kloper/thermo/README.md

# Thermo

Thermo is a work in progress project aiming to create an electronic thermometer
based on STM32F030 chip.

Follow me on http://kloper.blogspot.com for more info.
