kloper/thermo/doc/stm32f030-basic.PNG

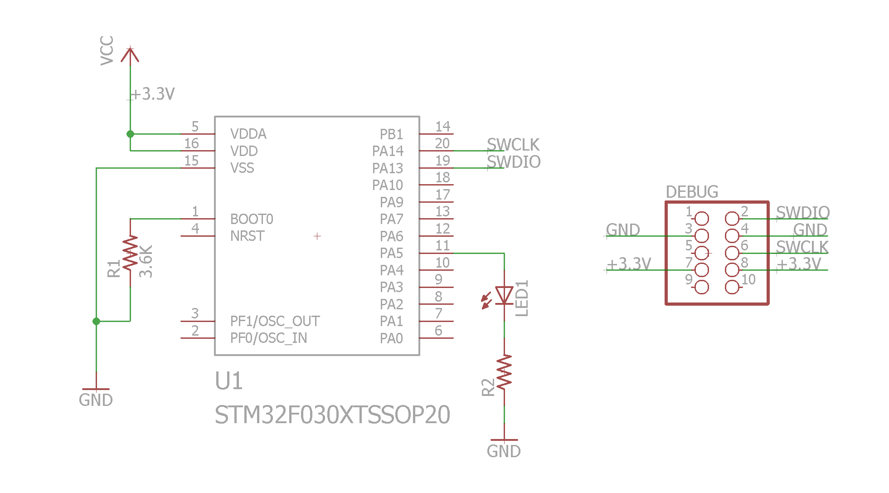
doc/stm32f030-basic.PNG
