kloper/thermo/kicad/thermo.kicad_pcb

## KiCad design kicad/thermo.kicad_pcb (2016-10-22)

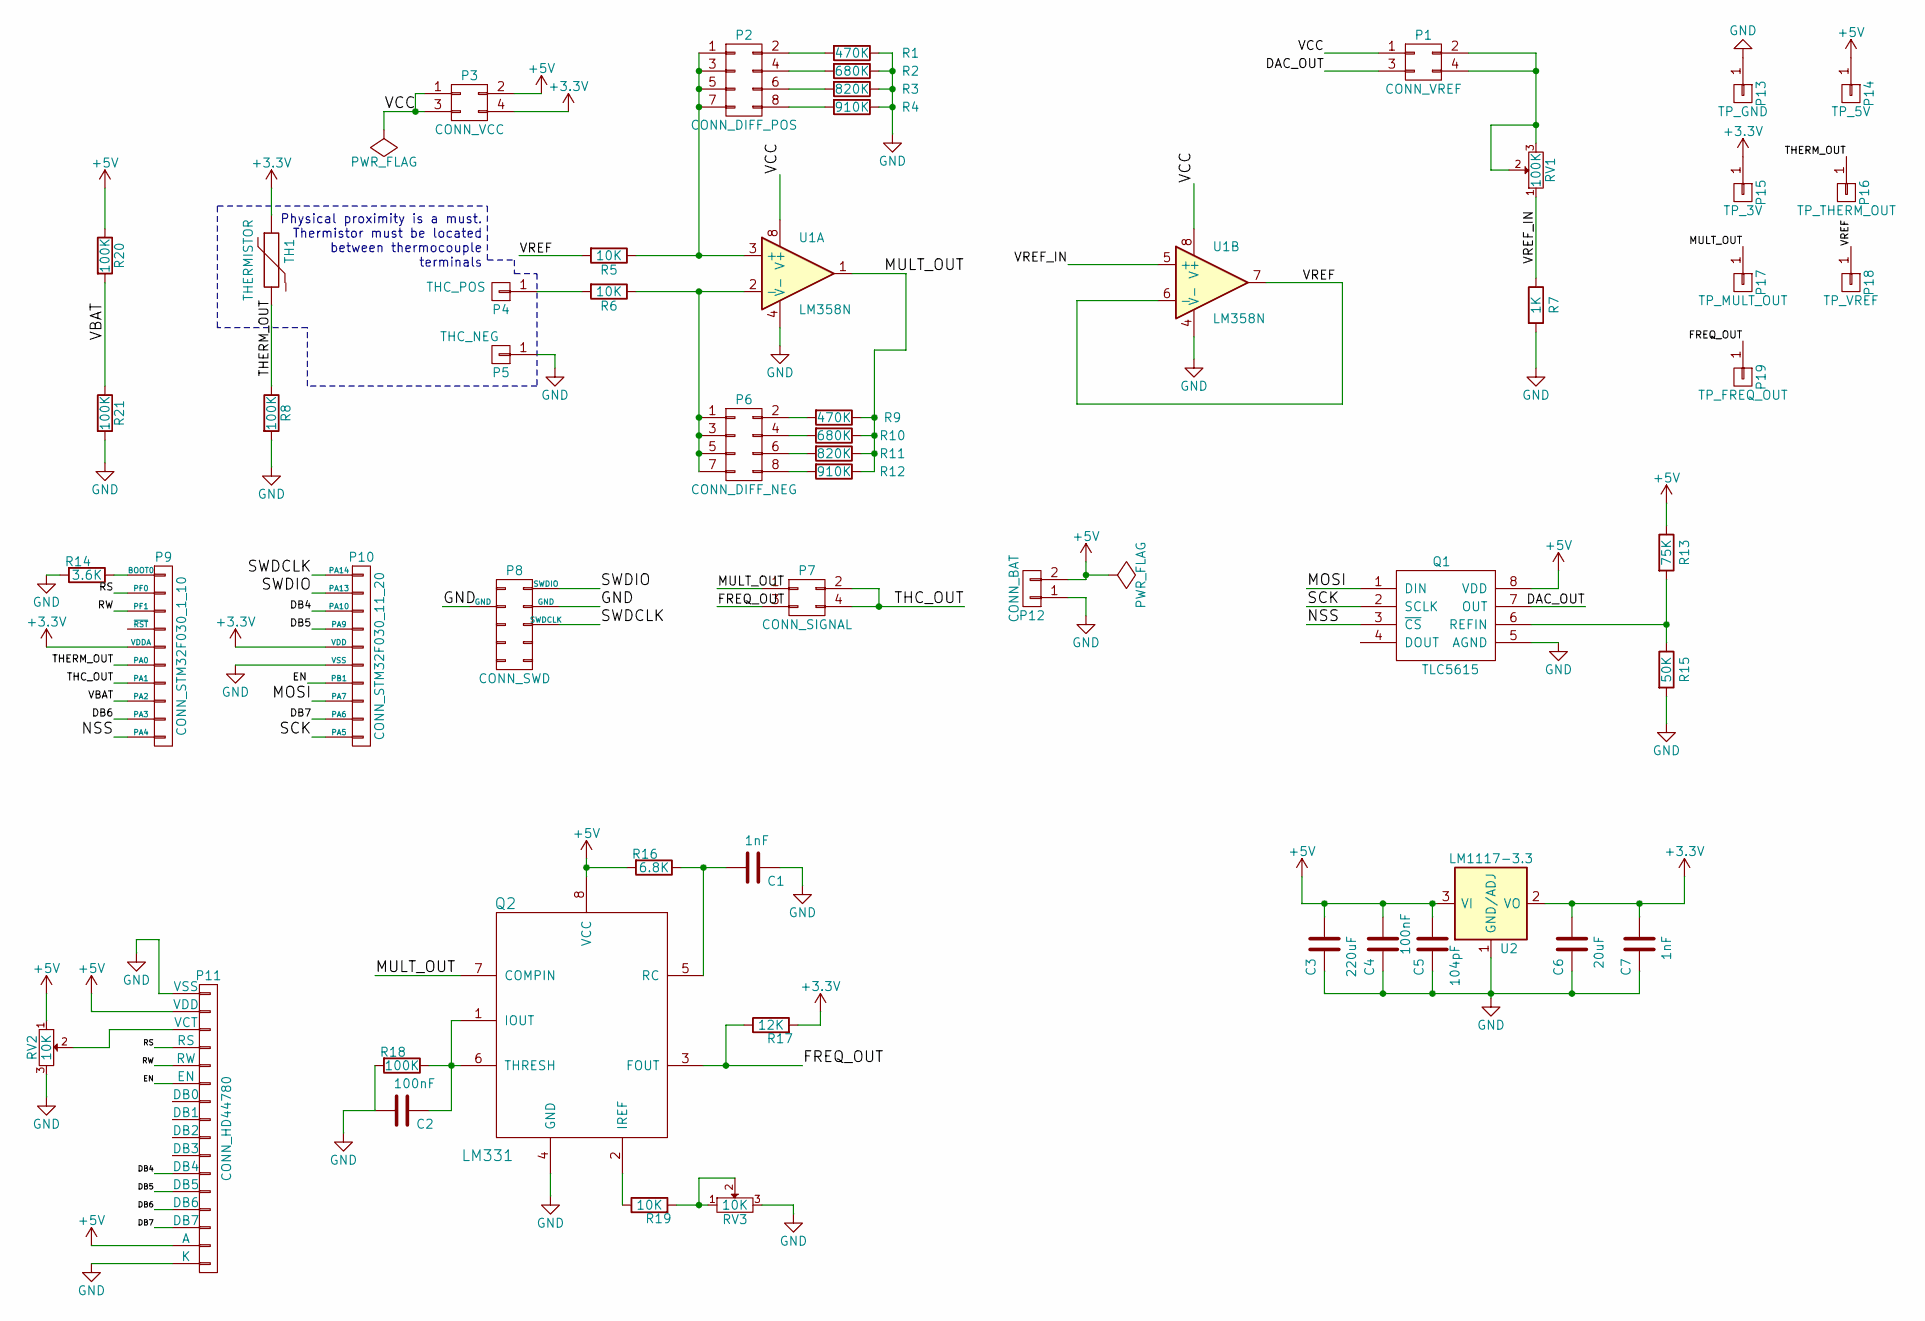
[picture p2: schematic thermo.sch, Thermo Develeopment Board]

Parts:
C1, C7: 1nF; C_Rect_L4_W2.5_P2.5
C2, C4: 100nF; C_Rect_L13_W4_P10
C3: 220uF; C_Radial_D5_L6_P2.5
C5: 104pF; C_Rect_L7_W2_P5
C6: 20uF; C_Radial_D5_L6_P2.5
P1: CONN_VREF; Pin_Header_Straight_2x02
P2: CONN_DIFF_POS; Pin_Header_Straight_2x04
P3: CONN_VCC; Pin_Header_Straight_2x02
P4: THC_POS; SolderWirePad_single_2-5mmDrill
P5: THC_NEG; SolderWirePad_single_2-5mmDrill
P6: CONN_DIFF_NEG; Pin_Header_Straight_2x04
P7: CONN_SIGNAL; Pin_Header_Straight_2x02
P8: CONN_SWD; Pin_Header_Straight_2x05
P9: CONN_STM32F030_1_10; Socket_Strip_Straight_1x10
P10: CONN_STM32F030_11_20; Socket_Strip_Straight_1x10
P11: CONN_HD44780; Socket_Strip_Straight_1x16
P12: CONN_BAT; Pin_Header_Straight_1x02
P13: TP_GND; Pin_Header_Straight_1x01
P14: TP_5V; Pin_Header_Straight_1x01
P15: TP_3V; Pin_Header_Straight_1x01
P16: TP_THERM_OUT; Pin_Header_Straight_1x01
P17: TP_MULT_OUT; Pin_Header_Straight_1x01
P18: TP_VREF; Pin_Header_Straight_1x01
P19: TP_FREQ_OUT; Pin_Header_Straight_1x01
Q1: TLC5615; DIP-8_W7.62mm
Q2: LM331; DIP-8_W7.62mm
R1, R9: 470K; R_0805_HandSoldering
R2, R10: 680K; R_0805_HandSoldering
R3, R11: 820K; R_0805_HandSoldering
R4, R12: 910K; R_0805_HandSoldering
R5, R6, R19: 10K; R_0805_HandSoldering
R7: 1K; R_0805_HandSoldering
R8, R18, R20, R21: 100K; R_0805_HandSoldering
R13: 75K; R_0805_HandSoldering
R14: 3.6K; R_0805_HandSoldering
R15: 50K; R_0805_HandSoldering
R16: 6.8K; R_0805_HandSoldering
R17: 12K; R_0805_HandSoldering
RV1: 100K; Potentiometer_Bourns_3296W_3-8Zoll_Inline_ScrewUp
RV2, RV3: 10K; Potentiometer_Bourns_3296W_3-8Zoll_Inline_ScrewUp
TH1: THERMISTOR; Resistor_Horizontal_RM12mm
U1: LM358N; DIP-8_W7.62mm
U2: LM1117-3.3; SOT-223

Connections:
+3V3: C6.2, C7.2, P3.4, P9.5 (VDDA), P10.5 (VDD), P15.1, R17.2, TH1.1, U2.2 (VO), U2.4 (VO)
+5V: C3.2, C4.2, C5.2, P3.2, P11.2 (VDD), P11.15 (A), P12.2, P14.1, Q1.8 (VDD), Q2.8 (VCC), R13.1, R16.2, R20.1, RV2.1, U2.3 (VI)
/DAC_OUT: P1.3, Q1.7 (OUT)
/DB4: P10.3 (PA10), P11.11 (DB4)
/DB5: P10.4 (PA9), P11.12 (DB5)
/DB6: P9.9 (PA3), P11.13 (DB6)
/DB7: P10.9 (PA6), P11.14 (DB7)
/EN: P10.7 (PB1), P11.6 (EN)
/FREQ_OUT: P7.3, P19.1, Q2.3 (FOUT), R17.1
/MOSI: P10.8 (PA7), Q1.1 (DIN)
/MULT_OUT: P7.1, P17.1, Q2.7 (COMPIN), R9.1, R10.1, R11.1, R12.1, U1.1
/NSS: P9.10 (PA4), Q1.3 (~CS)
/RS: P9.2 (PF0), P11.4 (RS)
/RW: P9.3 (PF1), P11.5 (RW)
/SCK: P10.10 (PA5), Q1.2 (SCLK)
/SWDCLK: P8.6 (SWDCLK), P10.1 (PA14)
/SWDIO: P8.2 (SWDIO), P10.2 (PA13)
/THC_OUT: P7.2, P7.4, P9.7 (PA1)
/THERM_OUT: P9.6 (PA0), P16.1, R8.1, TH1.2
/VBAT: P9.8 (PA2), R20.2, R21.1
/VCC: P1.1, P3.1, P3.3, U1.8 (V+)
/VREF: P18.1, R5.2, U1.6 (-), U1.7
/VREF_IN: R7.1, RV1.1, U1.5 (+)
GND: C1.1, C2.2, C3.1, C4.1, C5.1, C6.1, C7.1, P5.1, P8.3 (GND), P8.4 (GND), P10.6 (VSS), P11.1 (VSS), P11.16 (K), P12.1, P13.1, Q1.5 (AGND), Q2.4 (GND), R1.1, R2.1, R3.1, R4.1, R7.2, R8.2, R14.2, R15.2, R18.2, R21.2, RV2.3, RV3.3, U1.4 (V-), U2.1 (GND/ADJ)
unnamed: C1.2, Q2.5 (RC), R16.1
unnamed: C2.1, Q2.1 (IOUT), Q2.6 (THRESH), R18.1
unnamed: P1.2, P1.4, RV1.2, RV1.3
unnamed: P2.1, P2.3, P2.5, P2.7, R5.1, U1.3 (+)
unnamed: P2.2, R1.2
unnamed: P2.4, R2.2
unnamed: P2.6, R3.2
unnamed: P2.8, R4.2
unnamed: P4.1, R6.2
unnamed: P6.1, P6.3, P6.5, P6.7, R6.1, U1.2 (-)
unnamed: P6.2, R9.2
unnamed: P6.4, R10.2
unnamed: P6.6, R11.2
unnamed: P6.8, R12.2
unnamed: P9.1 (BOOT0), R14.1
unnamed: P11.3 (VCT), RV2.2
unnamed: Q1.6 (REFIN), R13.2, R15.1
unnamed: Q2.2 (IREF), R19.1
unnamed: R19.2, RV3.1, RV3.2

Notes on the sheet:
Physical proximity is a must. Thermistor must be located between thermocouple terminals

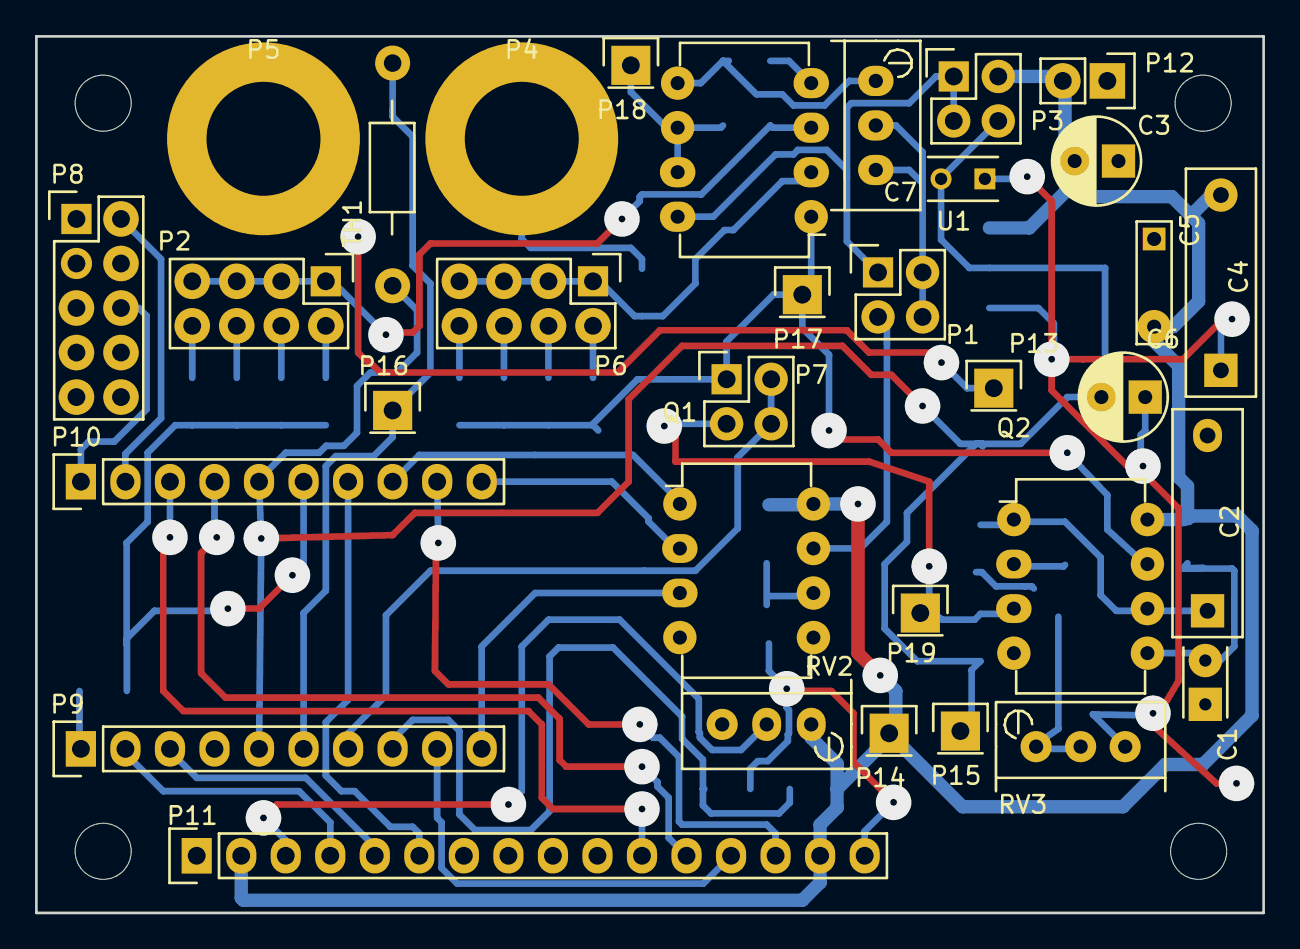
[picture p3: board thermo.kicad_pcb from above]

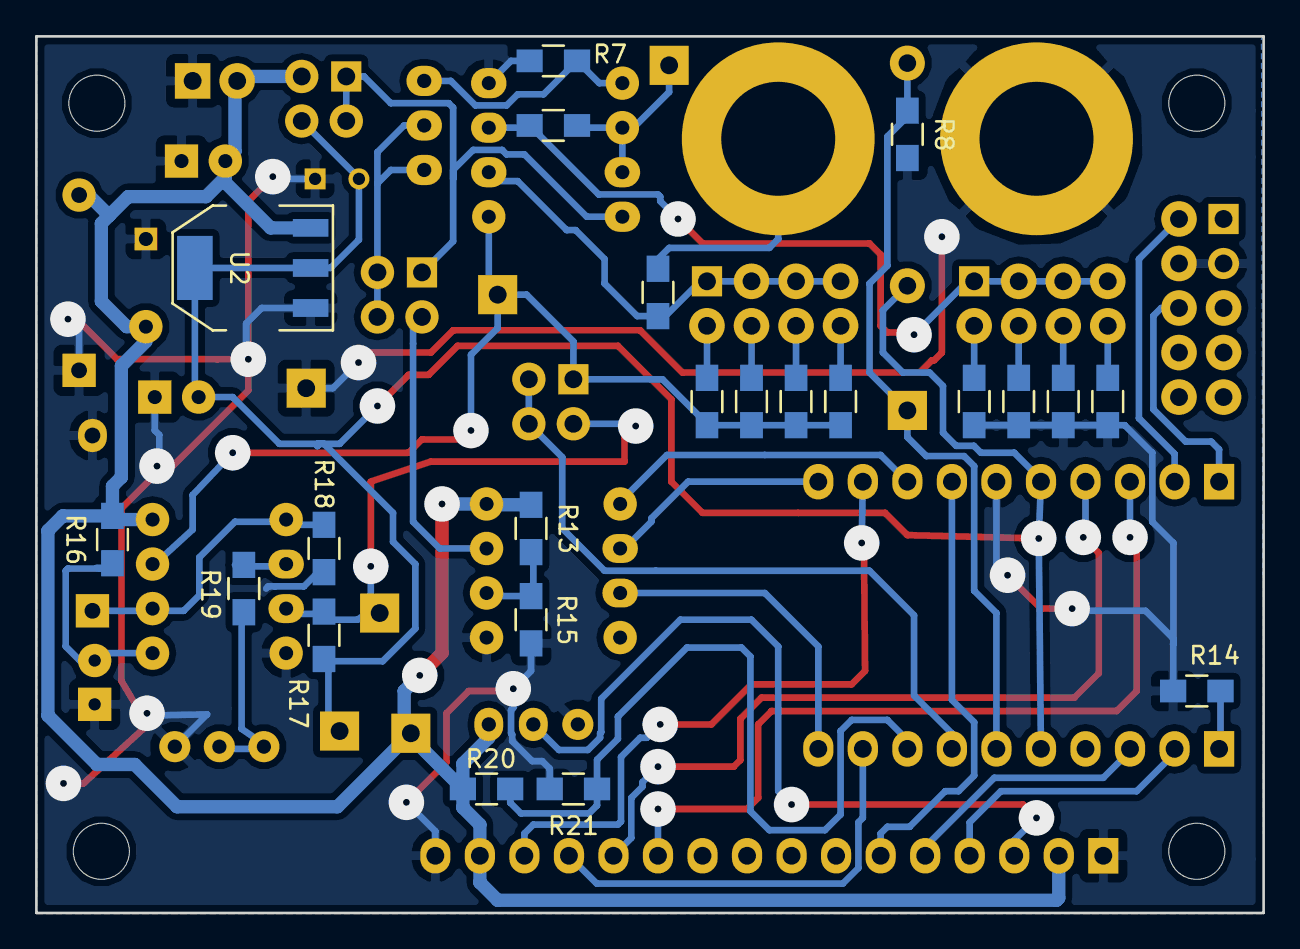
[picture p4: board thermo.kicad_pcb from below]

Board: 2 copper layers, 70.0 x 50.0 mm, 55 parts (22 on the bottom side), 43 nets.
