kloper/thermo/doc/eclipse-exclude-build.PNG

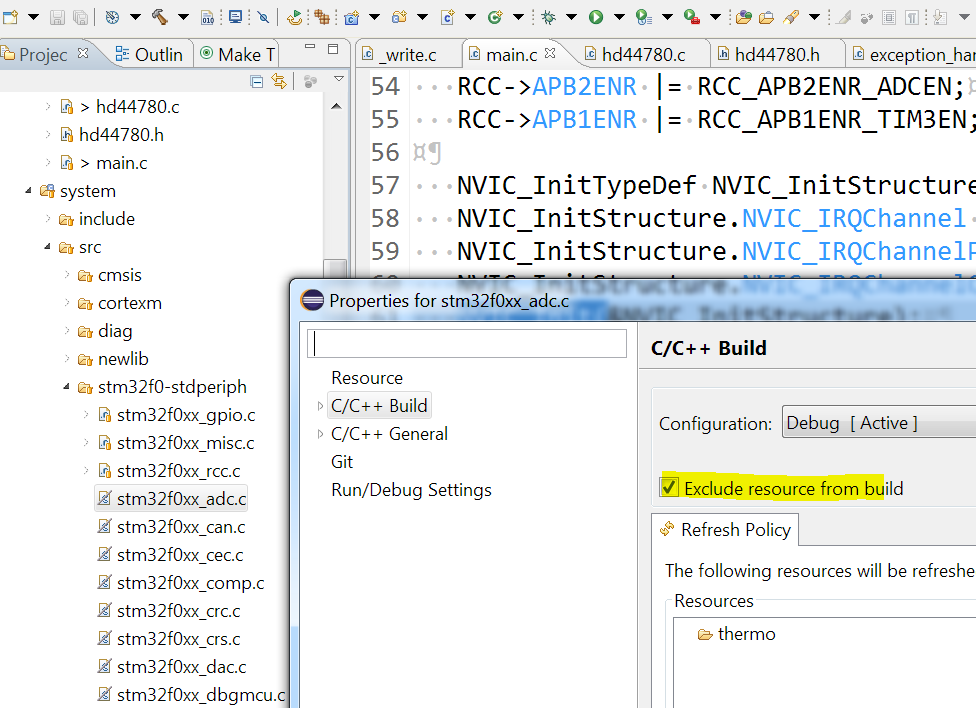
doc/eclipse-exclude-build.PNG
