kloper/thermo/(commit log)

2016-07-20 Initial import of empty sample project
    Auto-generated by eclipse STM32 plug-in
2016-07-23 Introduce a simple HD44780 display driver
    This is a simple and not very efficient port
    of pato HD44780 driver
2016-07-24 Introduce busy waiting based on TIM3
    Created very simple delay mechanism based on TIM3.
    In order to make fixed time delay we run the counter and wait
    for overrun interrupt in kind of busy wait, but with WFI
    which is hopefully less power consuming than simple
    looping.
    HD44780 code now uses the delay in display reset.
    [delay.c, delay.h, hd44780.c]
2016-07-26 Fix initial counter value in delay
    [delay.c]
2016-07-26 Introduce basic ADC acquisition
2016-07-30 Introduce Steinhard-Hart temperature approximation
    1. ADC has been switched to run on slowes cycle.
    2. Added reference to VREFINT_CAL and used it to convert ADC values to
    actual voltages.
    3. Added linear approximation for Steinhart-Hart equation to
    transform ADC voltage read from thermistor to a temperature.
    4. Added python code used to calculate the linear approximation.
2016-08-12 Add calculation of optimum sense resistor
2016-08-12 Introduce expotential averaging of ADC values
2016-08-12 Add delays to display functions + rewire display
    Physical connections changed, so the port definitions in the header.
    Added a few more NOPs into nibble_in/out operations to skip display
    artefacts.
    [hd44780.c, hd44780.h]
2016-08-12 Change Steinhart-Hart lenear approximation...
    ... to match new sense resistor and range.
2016-08-12 Use average values in main, fix formatting bug
    [main.c]
2016-08-12 Introduce ipython notebook for blog entry about thermistors
2016-08-12 Add missing thermistor schematics PNG
2016-08-12 Fix binary search upper bound initial value
    The upper index referencing a value beyond array
    causing possible out-of-bounds array access.
    [steinhart.c]
2016-08-12 Scale down thermistor schematics image
    Make it inline in the thermistor notebook
2016-08-12 Again, trying to make schematics image to show
2016-08-12 Yet another attempt to fix schematics
2016-08-17 Fix missing plots in thermistor notebook
2016-08-21 Make ADC to use fixed width average instead of exponential average
    The fixed width average resets after a predefined number of samples.
    It has a potential of spikes but has less 'memory' as the
    exponential average does.
    [adc.c, adc.h]
2016-08-21 Make the delay mechanism use processor events
    The problem with using of WFI is rase condition when
    the timer interrupt occurs just between condition check and
    WFI instruction and no additional interrupts
    occur. Then WFI blcoks forever.
    [delay.c, delay.h]
2016-08-23 Introduce thermocouple ADC to Celsius conversion
2016-08-23 Display cold and hot junction temperatures
2016-08-25 Fix some type conversion compiler warnings
    Most of the warnings are about constant to value
    conversion which is normally done ok by compiler.
    [adc.c, linapprox.c, main.c]
2016-08-25 Fix display noise quirk and remove unneeded delays
    The quirk is caused by not cleaning the data bus lines
    after nibble out operation. This caused the next nibble out
    to latch wring bus value immediately after EN goes high.
    [hd44780.c]
2016-08-25 Switch to -O1 compilation optimization
2016-10-12 Add prototype board KiCad project
    [thermo-pads.kicad_pcb, thermo.kicad_pcb, thermo.sch]
2016-10-22 Fix Vss and Vdd swapped on display connector
    [thermo-pads.kicad_pcb, thermo.kicad_pcb, thermo.sch]
2016-10-25 Make HD44780 with the new dev board
2016-10-25 Dev board has non-optimal 100K resistor in parallel with thermistor...
    Changed thermistor linear approximation to reflect that.
2016-11-19 Introduce run-time slow median filter on ADC values
    The filter works by saving 10 average values in FIFO per ADC channel
    and then infrequently applying sort to the queue and getting the
    median value.
    The implementation of the filter is inefficient but since the
    sorting is invoked infrequently I can live with it.
2016-12-10 Adapt code for new dev board settings
    1. The r2 resistors on lm358 has been set to 910K
    2. Vref = 10mV + Voffset
